rk2224/EEE-1st-Year-Project-28/README.md

# EEE-1st-yr-project
This repository is for group 28 EEE first year project documentation
