rk2224/EEE-1st-Year-Project-28/RadioDetector.asc

B1: bv; V=V(HI)*V(LO)
B2: bv; V= { if (sin(2*pi*150*time) > 0, cos(2*pi*89k*time)*0.2,0) }
C1: cap; 100n
C2: cap; 220n
C3: cap; 220n
D1: schottky; 1N5817
D2: diode
R1: res; 47k
R2: res; 100k
R3: res; 100k
R4: res; 1k
R5: res; 5k
R6: res; 5.7k
R7: res; 10k
R8: res; 26.3k
U1: AD8031
U2: AD8031
V1: voltage; SINE(0 1 89k)
V2: voltage; SINE(0 1 100
V3: voltage; 5
V4: voltage; 5
V5: voltage; 3.3
V6: voltage; SINE(0 5 150)
V7: voltage; 5
Named nets: 0, HI, LO
.tran 20ms
